634nakajima/GPUB/PCB/PCBパターン.png

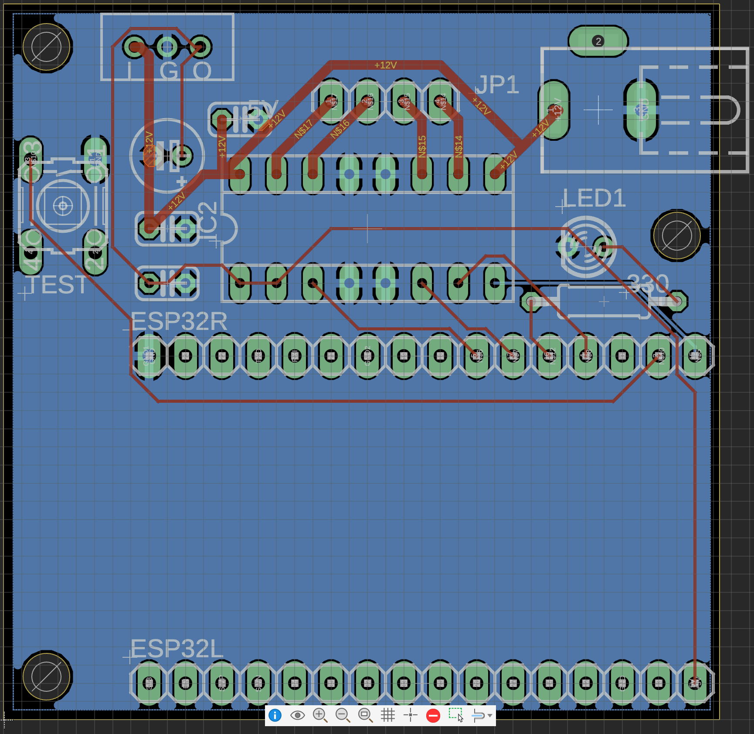
PCB/PCBパターン.png
