634nakajima/GPUB/PCB/回路図.png

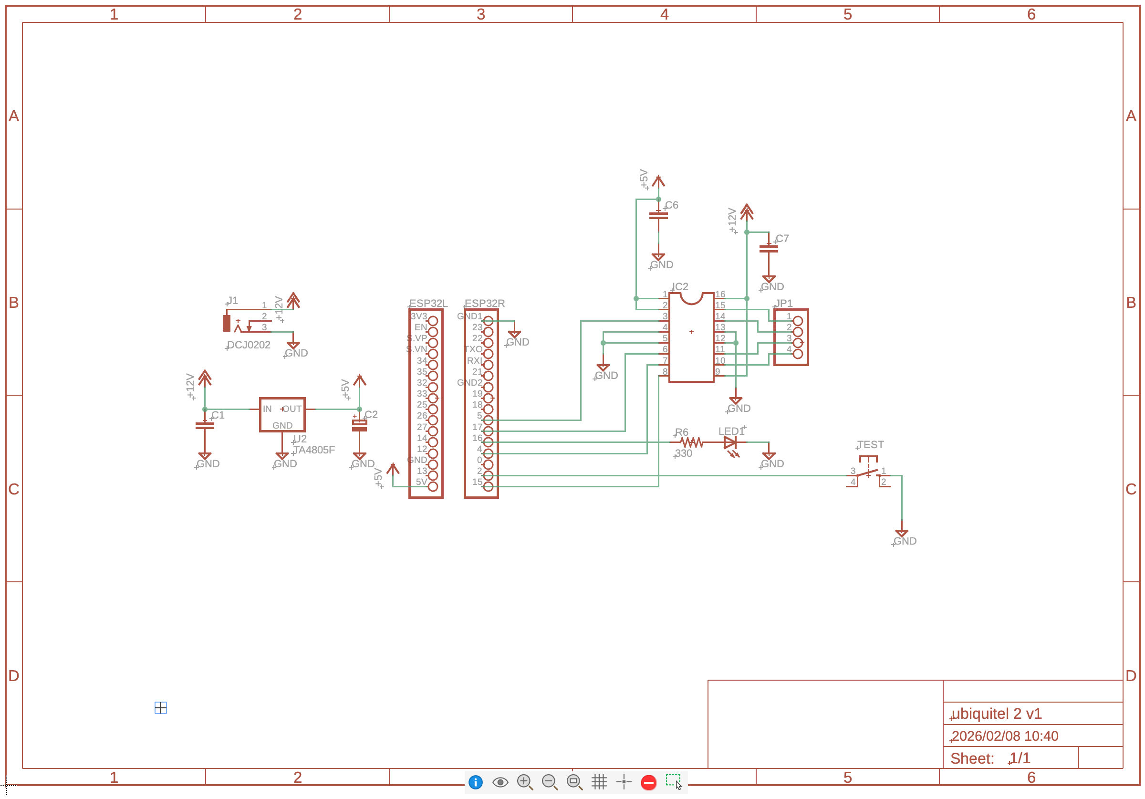
PCB/回路図.png
