634nakajima/GPUB/(commit log)

2026-03-27 Initial commit: ESP32 stepper motor controller with Socket.IO
    General-purpose firmware for stepper motor control (position, speed,
    direction) with Wi-Fi AP mode setup and GPIO output mode switching.
2026-03-27 Refactor to GPUB: general-purpose stepper motor + GPIO controller
    - Reorganize firmware into firmware/GPUB/ subfolder
    - Add Electron server app with Socket.IO, REST API, OSC support
    - Add motor.goto (absolute position), switch.pwm (freq-configurable PWM)
    - Add auto device cards, device simulator, EN/JA i18n UI
    - Add p5.js sample (motor-controller.html) and Pure Data sample (.pd)
    - Update README with full documentation
2026-03-27 Move external control samples into examples/ folder
2026-03-27 Update motor driver to TB6674PG in README
2026-03-27 Add GitHub Pages site
    - index.html with dark green theme matching the app
    - Hero with transparent GPUB logo
    - Features, REST API, OSC reference, download buttons
    - Favicon and apple-touch-icon
2026-03-27 Add OSC port change UI; change default OSC port to 9100
    - OSC server refactored into startOscServer(port) — restartable at runtime
    - Header shows inline port input + Apply button + active/error indicator dot
    - osc-status IPC event keeps renderer in sync after restart
    - Default OSC port changed from 9000 to 9100 across all files
2026-03-27 OSC port: auto-apply on blur/Enter, remove play button; broadcast button orange
